thieu-b55/Slimme-meter-ESP32-V2/Slimme meter.jpg

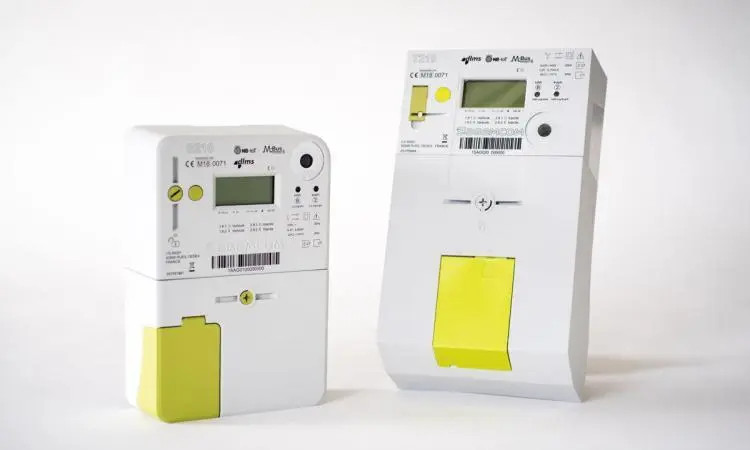
Slimme meter.jpg
