thieu-b55/Slimme-meter-ESP32-V2/Slimme meter ESP32 csv.pdf

# Slimme meter ESP32 V2 interface / sturing

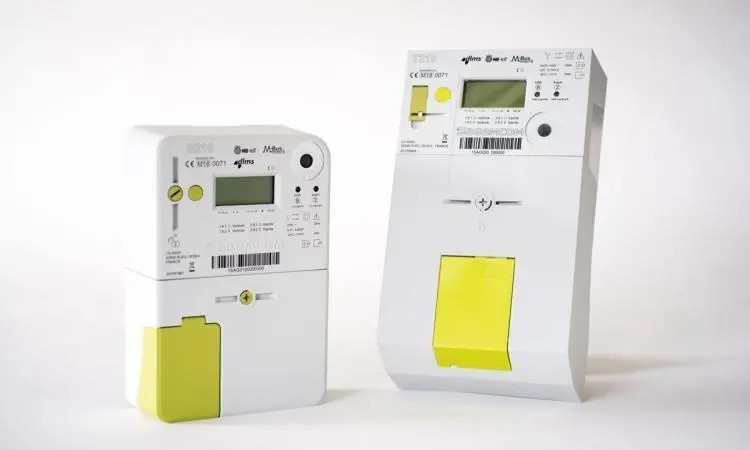
[picture p2: figure]

github pagina voor dit project

https://github.com/thieu-b55/Slimme-meter-ESP32-V2

## Wat kunnen we ermee ?

Inlezen van de P1 poort .
Voor activeren P1 poort zie volgend bladzijde.

## Verbruiksdata in csv formaat

tonen op webpagina of eventueel op display
dagelijks op einde van de dag beschikbaar via seriële poort verzamelen en bewaren op SD kaart.
uurbasis
dagbasis
maandbasis
jaarbasis
maandpiek op maandbasis
data opvraagbaar op :
dagbasis
maandbasis
jaarbasis
laatste 25 jaar (nog wel effe geduld hebben) meer hierover zie vanaf pagina 35
Extra display om verbruiksdata te tonen.

## Maximaal gebruik maken van de eigen opgewekte energie (terugleveren is momenteel toch

redelijk onrendabel)

## 2x PWM uitgang

## 2x Digitale uitgang

## PWM1 uitgang

Kan gebruikt worden voor het sturen van een elektrische boiler, elektrische bijverwarming of eventueel een zwembadverwarming.
Zorgt er door de PWM regeling voor dat er niet meer vermogen naar het verwarmingselement gaat dan dat er door de zonnepanelen geleverd wordt.

## PWM2 uitgang

Doet hetzelfde als PWM1 maar deze regeling wordt pas actief wordt bij een 100% uitsturing van PWM1

## Digitale uitgangen Relais1 en Relais2

Deze kunnen geschakeld worden op tijdsbasis, wanneer er een bepaald vermogen wordt opgewekt of een combinatie van de 2.

## Enkele nuttige adressen:

Meer info over de slimme meter vind je hier https://jensd.be/1205/linux/data-lezen-van-de-belgische-digitale-meter-met-de-p1-poort

handleidingen Nederlandse Slimme meters https://www.netbeheernederland.nl/slimme-meter/slimme-meter-veelgestelde-vragen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* MTczMDU0NTg3Mi4xLjEuMTczMDU0NTg5Mi4wLjAuMA.. (https://www.netbeheernederland.nl/slimme-meter/slimme-meter-veelgestelde-vragen)
bijna op het einde van de pagina.

https://www.fluvius.be/nl/meters-en-meterstanden/digitale-meter/hoe-werkt-mijn-digitale-meter/handleidingen-digitale-elektriciteitsmeters (https://www.fluvius.be/nl/meters-en-meterstanden/digitale-meter/hoe-werkt-mijn-digitale-meter/handleidingen-digitale-elektriciteitsmeters)

Meer info over de OBIS code
https://onemeter.com/docs/device/obis/

De ESP32 wordt geprogrammeerd met de Arduino IDE hoe je deze en de benodigde ESP32 software op je PC moet installeren vind je hier https://randomnerdtutorials.com/installing-the-esp32-board-in-arduino-ide-windows-instructions/

Meer info over ESP32 en nog veel meer
https://randomnerdtutorials.com/projects-esp32/

De P1 poort gratis activeren doe je via Fluvius https://www.fluvius.be/nl/thema/meters-en-meterstanden/digitale-meter/maak-je-meter-slim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 (https://www.fluvius.be/nl/thema/meters-en-meterstanden/digitale-meter/maak-je-meter-slim)

Er zijn meerdere types “slimme meter” in omloop. De aansluitingen en software van dit project zijn gebaseerd op het type meter hierboven afgebeeld. Meer info over de andere meters vind je op de link hieronder.
https://domoticx.com/p1-poort-slimme-meter-hardware/

## ### Compileren met Arduino core for ESP32 versie 3.0.5 ###

Gebruik de volgende libraries :

https://github.com/me-no-dev/AsyncTCP

https://github.com/me-no-dev/ESPAsyncWebServer

Op de github pagina:

https://github.com/thieu-b55/Slimme-meter-ESP32-V2

in de bin folder is er van elk programma een .bin file aanwezig, indien een niet compatibele update het compileren van een programma verhindert kan deze .bin file in de ESP32 geladen worden. Meer info zie tekst file in .bin folder.

## Dit project is opgebouwd uit 4 modules

## Interface module

Deze leest de data uit de P1 poort van de slimme meter in en maakt deze beschikbaar voor verdere verwerking.
De ESP32 is ingesteld in de Access Point Mode en heeft zijn eigen netwerk namelijk:
Netwerk: | ESP32Energie_csv
Paswoord: | ESP32pswd
IPaddress: | 192.168.4.1

## Display Module

Weergave van :

Totaal elektriciteitsverbruik

Totaal injectie

Totaal gasverbruik

Huidig verbruik (rood) of injectie (groen)

Status van de 2 digitale en de 2 PWM uitgangen

## PWM Module

Voor het sturen van bijvoorbeeld een elektrische boiler of elektrische verwarmingstoestel in functie van het zelf opgewekt vermogen.

## Output Module

Voor het sturen van een uitgang op een gewenst ogenblik, als er een gewenst vermogen wordt opgewekt of een combinatie van de 2.

## Interface Module

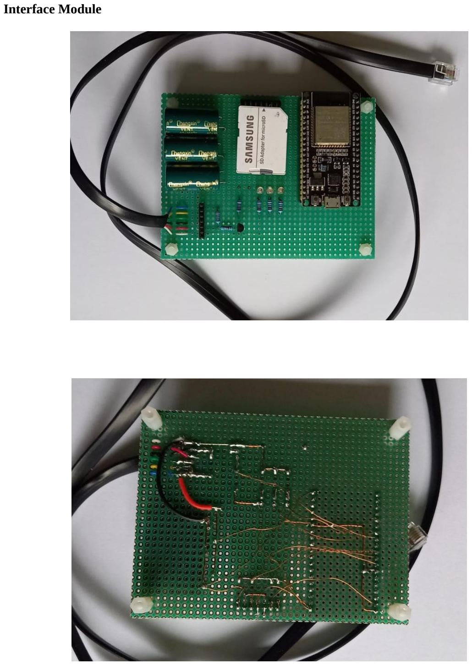
[picture p3: page 6]

Leest de gegevens van de P1 poort en stuurt deze naar een webpagina SD kaart.

Mogelijkheid voor het sturen van 2 digitale en 2 PWM uitgangen in functie van het opgewekt vermogen
op tijdsbasis.

Stuurt gegevens eventueel door naar apart LCD scherm.

Bewaart data op SD kaart dit voor zowel elektriciteitsverbruik, elektriciteitsinjectie, maandpiek en indien aanwezig aardgas.
Dit per uur , dag , maand , jaar. Maandpiek alleen per maand.

Een volledig jaar beslaat +/- 140 KB op een SD kaart. 16GB volstaat voor enkele honderden jaren.

Alvorens de P1 poort op de meter te kunnen gebruiken, moet deze eerst geactiveerd worden. Voor België moet dit gebeuren via Fluvius.

https://www.fluvius.be/nl/meters-en-meterstanden/digitale-meter/maak-je-meter-slim?app-refresh=1730576514541 (https://www.fluvius.be/nl/meters-en-meterstanden/digitale-meter/maak-je-meter-slim?app-refresh=1730576514541)

## Onderdelen

1 x kabeltje met RJ12 plug 1x ESP32WROOM Devkit
1x SD card module

of
1x SD card houder

indien deze optie
4x 10K extra

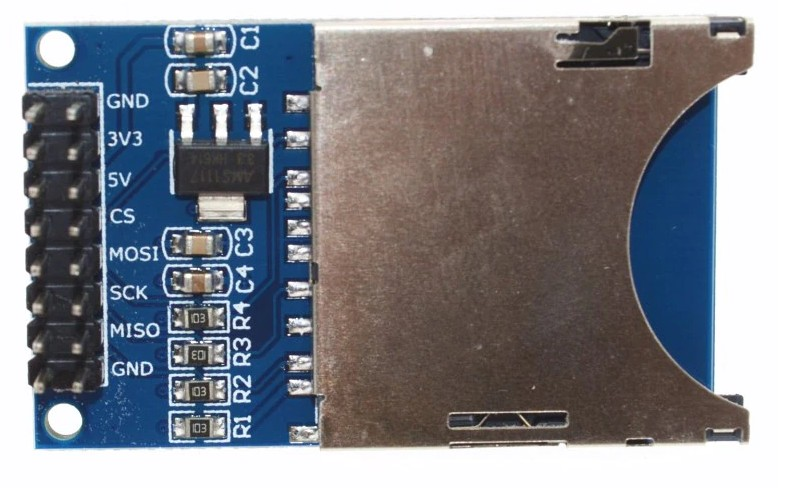
[picture p4: figure]
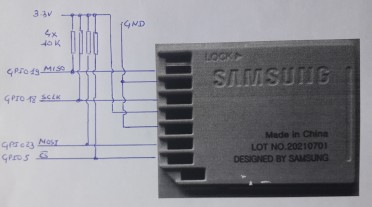
[picture p5: figure]

1 x SD kaart FAT32 geformatteerd. 1x BC547
3x LED
1x R 1K
1x R 10K
1x R 2K2
3 x R20K
3x 4700 uF / 16 Volt
(eventueel een aparte 5 Volt voeding zie beschrijving)

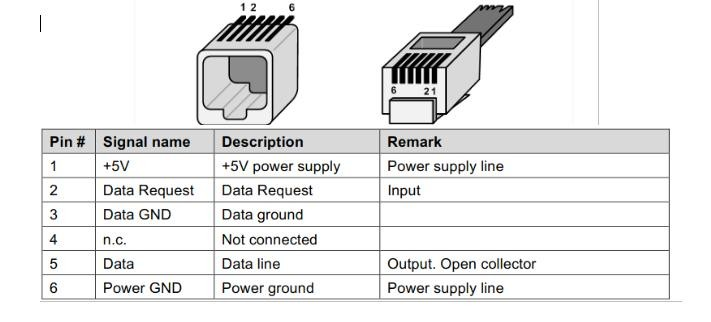
[picture p6: figure]
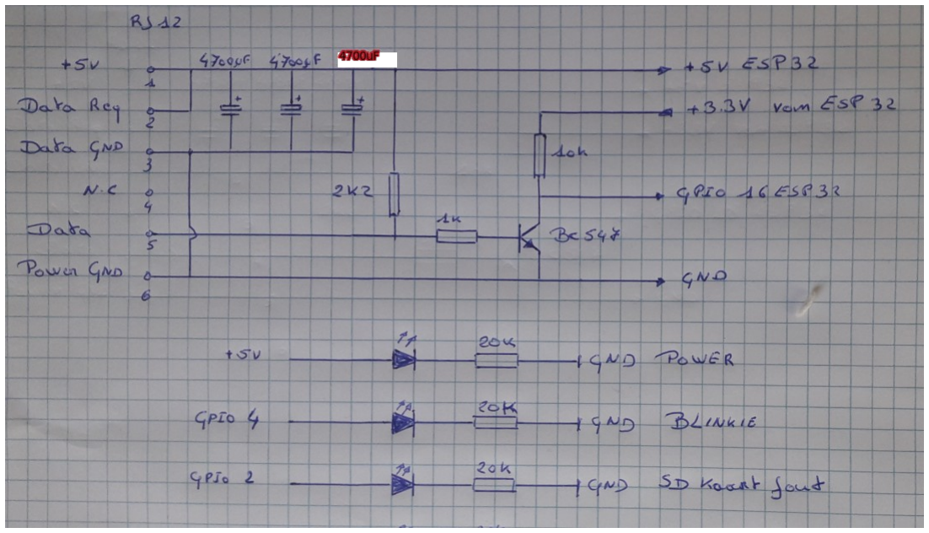
[picture p7: figure]

Volgens de beschrijving kan deze P1 poort 5 Volt 250 mA leveren. Dit is niet genoeg voor de ESP32 module om data te kunnen doorsturen. 3 capaciteiten kunnen dit probleem verhelpen. Enige nadeel is dat na het inpluggen of een eventuele (zeldzame) spanningsuitval de ESP32 module manueel moet gereset worden. Een externe 5 Volt voeding gebruiken kan ook , de 3 capaciteiten zijn dan niet nodig. Ontkoppel dan ook de 5V komende van de meter, Pin2 (Data Request) moet dan wel met de 5V van de meter verbonden blijven.

## Verbindingen

## Aansluitingen ESP32

GPIO23 | >> | MOSI SD kaart
GPIO19 | >> | MISO SD kaart
GPIO18 | >> | SCK SD kaart
GPIO5 | >> | CS SD kaart
GPIO16 | << | BC547 collector uitgang, P1 signaal digitale meter
GPIO4 | >> | LED (BLINKIE) verandert status bij elke leescyclus data
| | van P1 poort. Indien OK frequentie 0.5Hz (1 leescyclus per seconde)
GPIO2 | >> | LED SD ERROR. 1 bij SD kaart error
5V | << | van P1 poort of externe voeding
3x GND | << | van P1 poort /externe voeding
3.3V | >> | 3.3V SD kaart
| >> | 10k in collector lijn BC547

## Aansluitingen SD module of SD houder

3.3V | << | 3.3V van ESP32
GND | << | GND
/CS | << | GPIO5 ESP32
SCK | << | GPIO18 ESP32
MOSI | << | GPIO23 ESP32
MISO | >> | GPIO19 ESP32

indien er een SD kaarthouder wordt gebruikt verbindt /CS, SCK, MOSI, MISO via R10K met 3.3V van ESP32
Laad programma Slimme_meter_esp32_csv.ino in de ESP32.

Plug de module in de geactiveerde P1 poort van de Slimme Meter. Indien geen externe voeding druk op resetknop van de ESP32 Devkit. Na een 30-tal seconden begint de BLINKIE Led te pinken.

Maak verbinding met:
Netwerk | ESP32Energie_csv
Paswoord | ESP32pswd
IP adres | 192.168.4.1

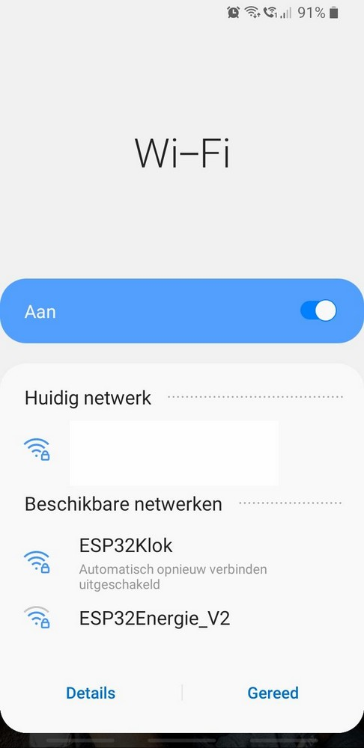
[picture p8: figure]
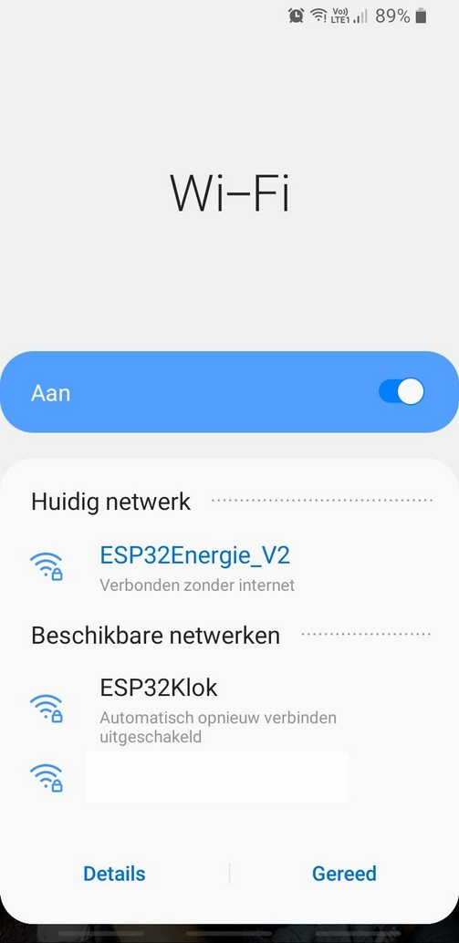
[picture p9: figure]

## Hoofdpagina

Ga naar pagina 192.168.4.1

Dit is de hoofdpagina met:

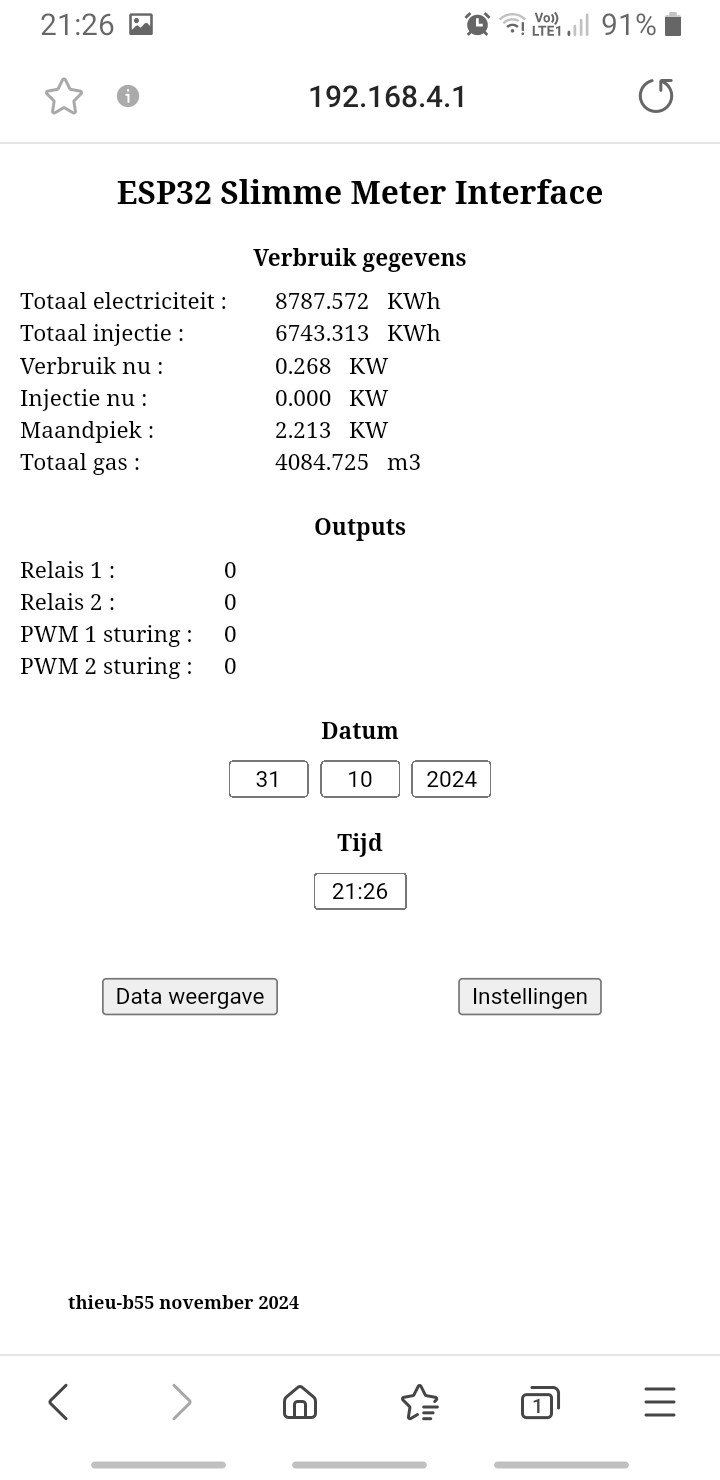
[picture p10: figure]

Totaal elektriciteitsverbruik Totaal injectie
Verbruik nu
Injectie nu
Maandpiek
Totaal gas

Tevens zien we onder Outputs de status van de digitale en PWM outputs, hierover verder meer.

Datum en Tijd komen van de Slimme Meter

Met behulp van de 2 drukknoppen kunnen we kiezen voor <Data weergave>
<Instellingen>

## Instellingen

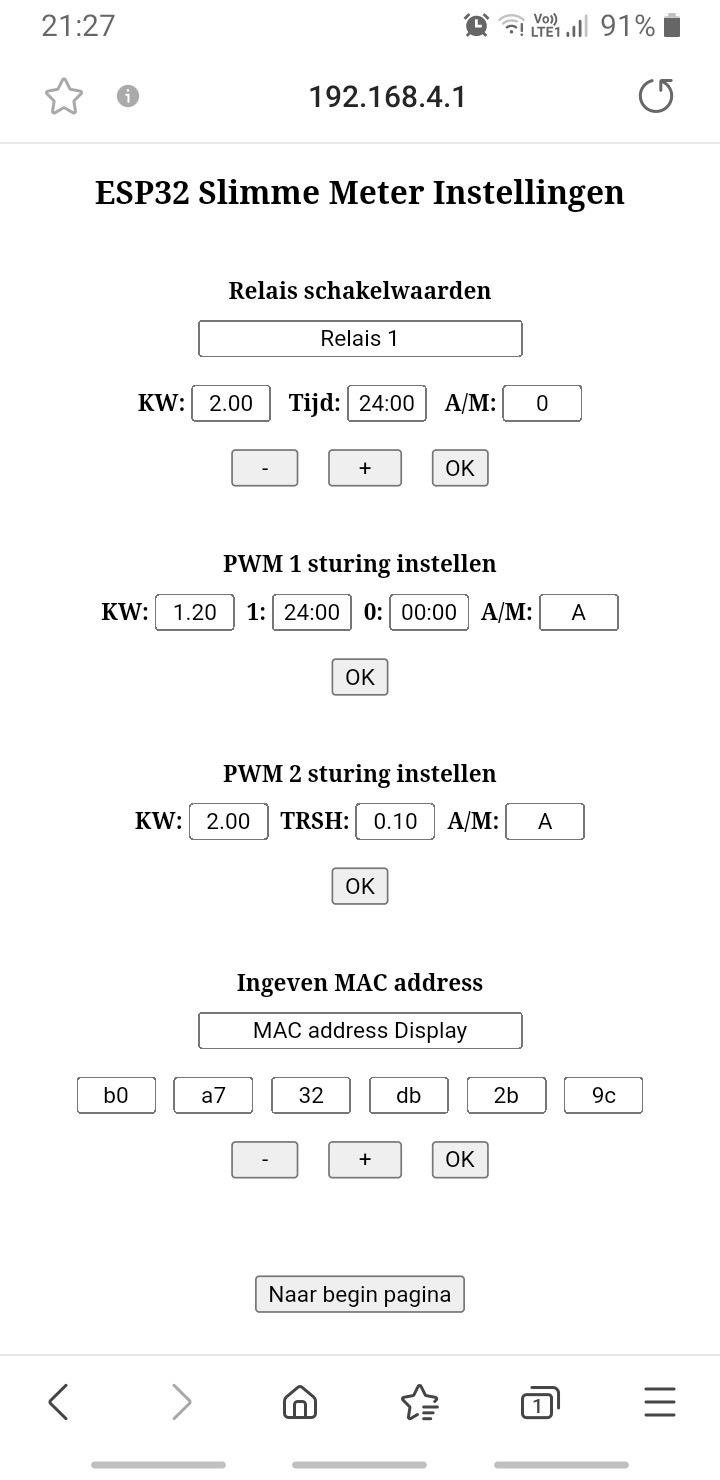
[picture p11: figure]

## Relais schakelwaarden

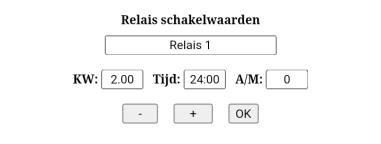
[picture p12: figure]

met behulp van de <-> <+> en <OK> knop kunnen we kiezen tussen Relais 1 en Relais 2

## Werking :

KW | vul hier de waarde in die er opgewekt moet worden alvorens de uitgang "1" kan
worden
Tijd | vul hier het uur in dat de uitgang "1" kan worden
A/M | 0 uitgang "0"
1 uitgang "1"
A uitgang wordt gestuurd door settings

voorbeeld
KW | 1
Tijd | 12:00
A/M | A

Uitgang wordt 1 als:
het 12:00 uur is of later
en
het opgewekt vermogen gelijk wordt aan of groter wordt dan de ingestelde 1KW

een uitgang die eenmaal uitgestuurd is, blijft gestuurd. Dus ook als het opgewekt vermogen daalt onder de ingestelde KW in ons voorbeeld 1 KW.
Uitgangen worden gereset om 00:00 uur.
Om alleen de tijdfunctie te gebruiken | >> zet KW op 0 en Tijd op de gewenste tijd.
Om alleen de KW functie te gebruiken | >> zet Tijd op 00:01 en KW op het gewenste opgewekte
vermogen.

Na het invullen van de gewenste waarden druk op <OK> om te accepteren.

## PWM1 sturing instellen

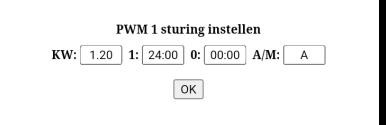
[picture p13: figure]

KW vul hier zo correct mogelijk het vermogen in van de aangesloten verbruiker, dit om een zo stabiel mogelijke regeling te krijgen

### 1 tijd waarop het PWM signaal 100% wordt uitgestuurd 0 stuurt het PWM signaal terug naar 0%

Dit kan gebruikt worden om bij gebruik als aansturing voor een warmwaterboiler altijd verzekerd te zijn van warm water.
Gedurende de dag wordt de boiler opgewarmd met het opgewekte vermogen van de zonnepanelen om dan bijvoorbeeld vanaf 20:00 to 23:30 de warmwaterboiler via de tijdsschakeling bij te warmen. Op die manier heeft men altijd warm water ook op een minder zonnige dag.

A/M 0: PWM1 wordt 0% uitgestuurd
| 1: PWM1 signaal wordt 100% uitgestuurd A: percentage uitsturing PWM signaal is afhankelijk van het opgewekte vermogen en het vermogen van de belasting die is ingesteld in KW

De regeling tracht het vermogen naar de belasting zo te regelen dat dit overeenkomt met het beschikbaar geïnjecteerd vermogen.

## PWM2 sturing instellen

KW vul hier zo correct mogelijk het vermogen in van de aangesloten verbruiker, dit om een zo stabiel mogelijke regeling te krijgen

TRSH vul hier een waarde in in KW. Indien PWM1 100% is uitgestuurd en er is nog zelf
| opgewekt vermogen beschikbaar, dan probeert de regeling het vermogen naar de verbruiker zo te regelen dat er nog steeds een vermogen gelijk aan de waarde hier ingevuld beschikbaar blijft. Dit om de regeling van PWM1 zo weinig mogelijk te verstoren met de regeling van PWM2

A/M 0: PWM2 wordt 0% uitgestuurd
| 1: PWM2 wordt 100% uitgestuurd A: percentage uitsturing PWM2 is afhankelijk van PWM1 = 100% nog beschikbaar opgewekt vermogen > waarde ingevuld in TRSH

Bij PWM1 = 100% en nog beschikbaar opgewekt vermogen > TRSH probeert de regeling het nog beschikbaar opgewekt vermogen zo te regelen dat deze gelijk is aan de waarde ingevuld in TRSH

De combinatie van PWM1 met PWM2 kan gebruikt worden om het maximum aan opgewekte energie zelf te gebruiken.
PWM1 als aansturing voor een warmwaterboiler.
Met PWM2 kan dan het nog resterende gedeelte van de opgewekte energie naar een simpel elektrische bijverwarming gestuurd worden,.
Momenteel bedraagt het bedrag dan men krijgt voor 1KWh geïnjecteerd vermogen 0.04€ (Luminus november 2024) en de prijs voor 1KWh gas +/- 0.09€ (Engie 2024).
Elke KWh gas die men kan vervangen door een KWh opgewekte elektriciteit levert dus 0.05€ op. Rijk zal men er niet van worden, maar het blijft een hobby natuurlijk.
Voor in de zomermaanden is dit geen oplossing maar eventueel kan er de verwarming van een zwembad of jacuzzi op aangesloten worden.
Goede ideeën altijd welkom.

## Ingeven MAC address

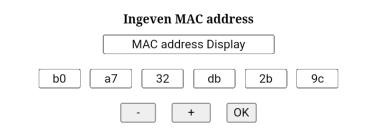
[picture p14: figure]

Om te kunnen functioneren moet voor elke aparte module het juiste MAC address ingevuld zijn. Om het MAC Address te kennen kijk na het uploaden van een programma naar een ESP32 Devkit naar de Arduino IDE, het MAC Address van de module vind je onder in het terminal gedeelte van de IDE

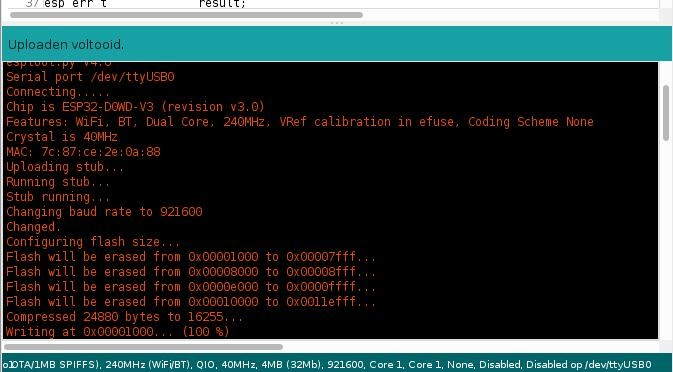
[picture p15: figure]

het MAC Address van deze module is 7c:87:ce:2e:0a:88

kies met behulp van de < + > < - > en < OK > knop van welke module je het MAC address wil invullen.
2 modules hetzelfde MAC Address geven resulteert in een continue reset van de ESP32 Devkit. Na het invullen en accepteren door middel van de < OK > knop van een (1) MAC Address herstart de ESP32 Devkit automatisch.

Eventueel kunnen de MAC adressen ook al ingevuld worden in het programma. Dit in de Setup()

/*
* Display
*/
pref.putInt("mac1_0", 0xb0); pref.putInt("mac1_1", 0xa7); pref.putInt("mac1_2", 0x32); pref.putInt("mac1_3", 0xdb); pref.putInt("mac1_4", 0x2b); pref.putInt("mac1_5", 0x9c); /*
* Relais 1
*/
pref.putInt("mac2_0", 7);
pref.putInt("mac2_1", 1);
pref.putInt("mac2_2", 2);
pref.putInt("mac2_3", 3);
pref.putInt("mac2_4", 4);
pref.putInt("mac2_5", 7);
/*
* Relais 2
*/
pref.putInt("mac3_0", 2);
pref.putInt("mac3_1", 1);
pref.putInt("mac3_2", 2);
pref.putInt("mac3_3", 3);
pref.putInt("mac3_4", 4);
pref.putInt("mac3_5", 5);
/*
* PWM 1
*/
pref.putInt("mac4_0", 0x7c); pref.putInt("mac4_1", 0x9e); pref.putInt("mac4_2", 0xbd); pref.putInt("mac4_3", 0x06); pref.putInt("mac4_4", 0xb4); pref.putInt("mac4_5", 0xdc); /*
* PWM 2
*/
pref.putInt("mac5_0", 0x7c); pref.putInt("mac5_1", 0x87); pref.putInt("mac5_2", 0xce); pref.putInt("mac5_3", 0x30); pref.putInt("mac5_4", 0x7e); pref.putInt("mac5_5", 0x24);

## Naar begin

druk op <Naar begin pagina> om naar de begin pagina te gaan.

## Data weergave

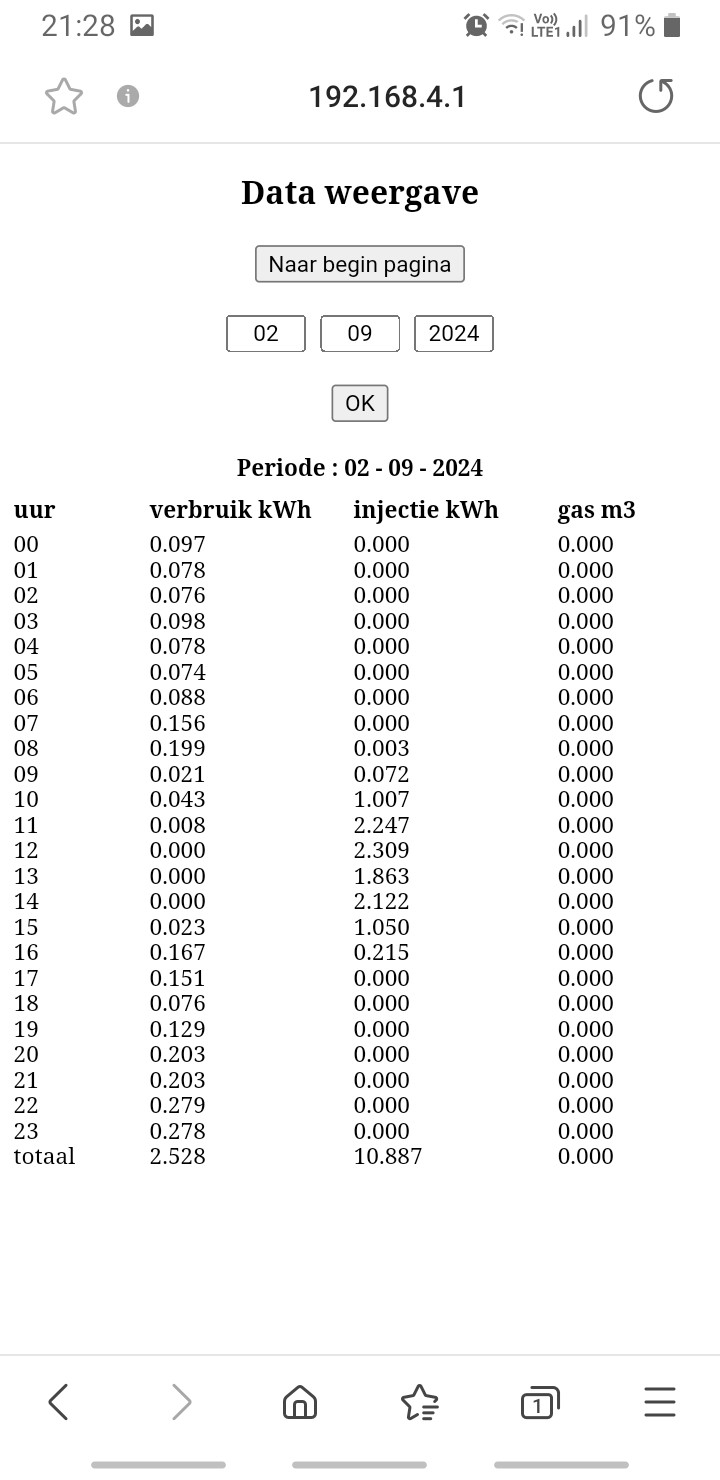
[picture p16: figure]

Vul dag - maand – jaar in om het uurverbruik van die bepaalde dag op te vragen

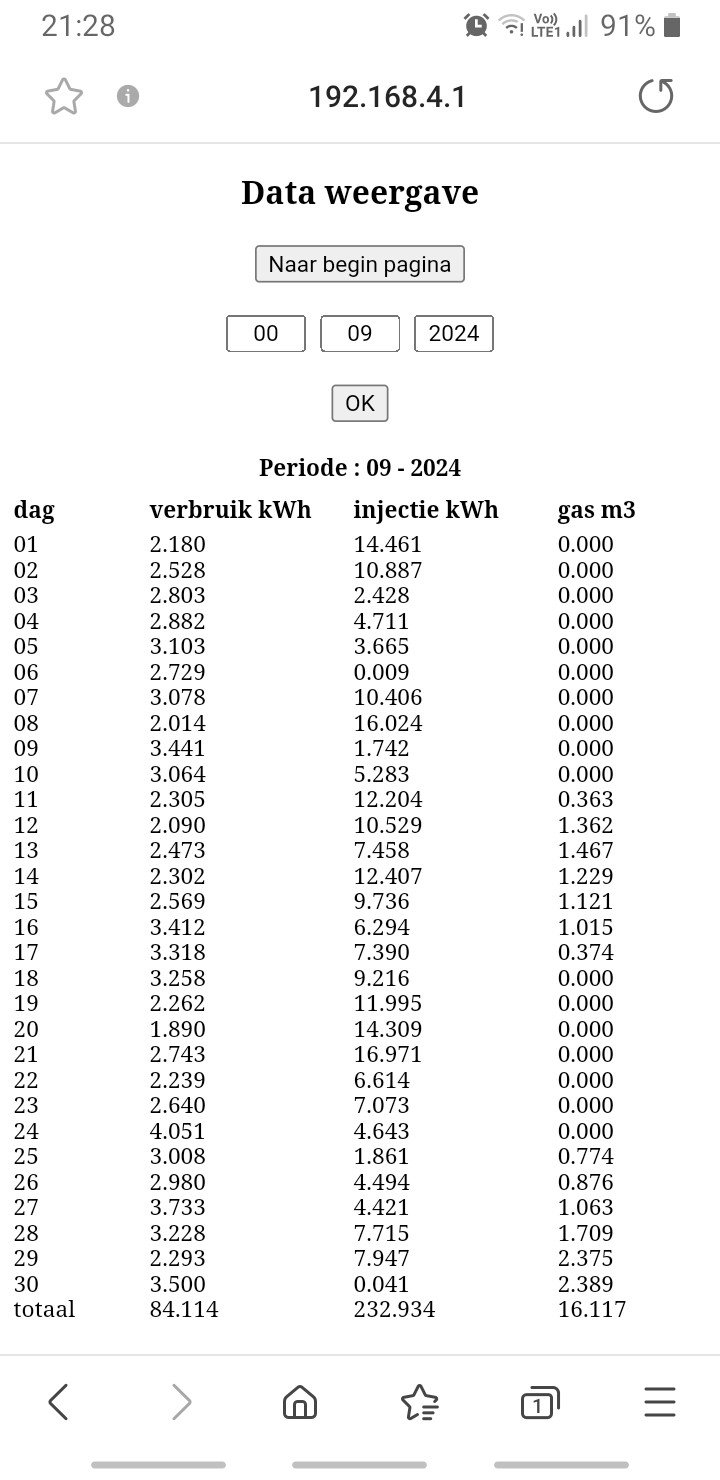
[picture p17: figure]

vul 0 – maand – jaar in om het dag verbruik van die bepaalde maand op te vragen

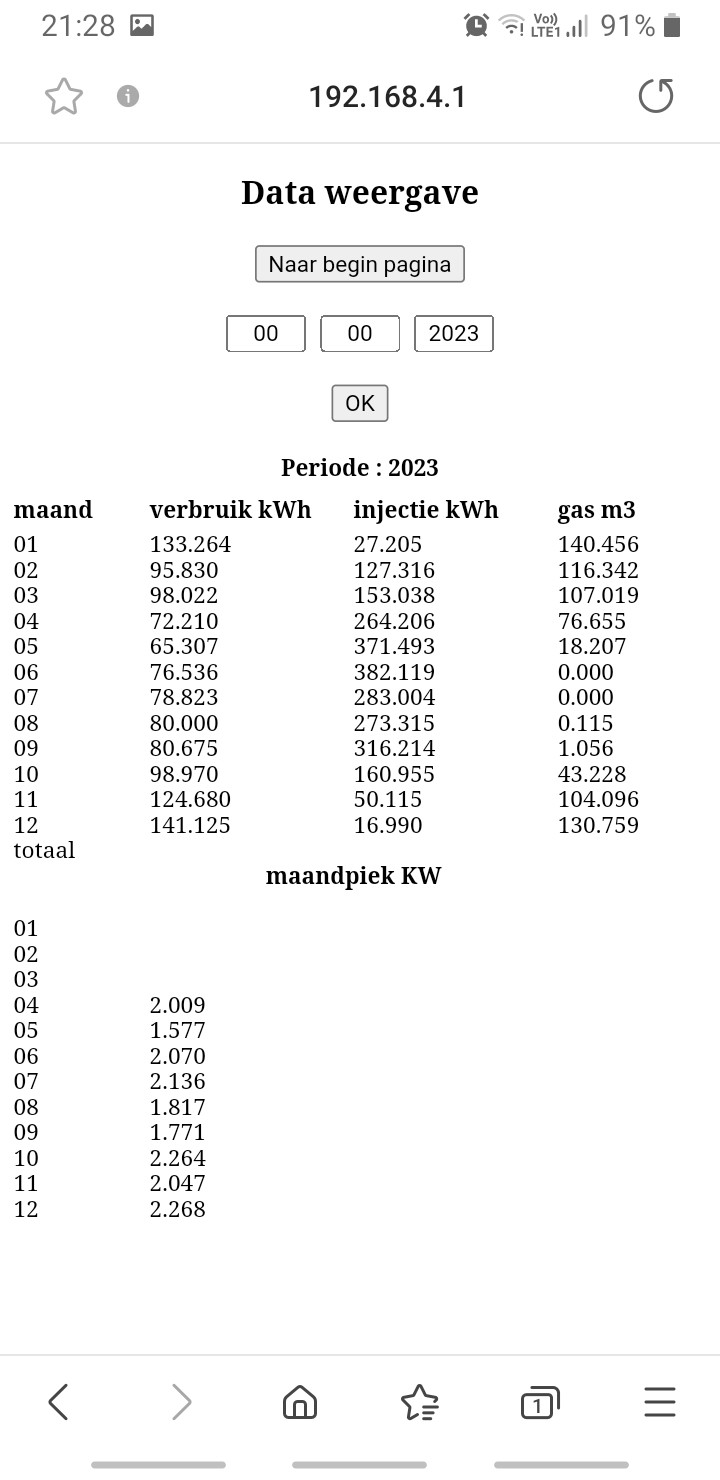
[picture p18: figure]

vul 0 - 0 - jaar in om het maandverbruik van dat bepaald jaar op te vragen. Ook de maandelijkse maandpiek wordt nu getoond

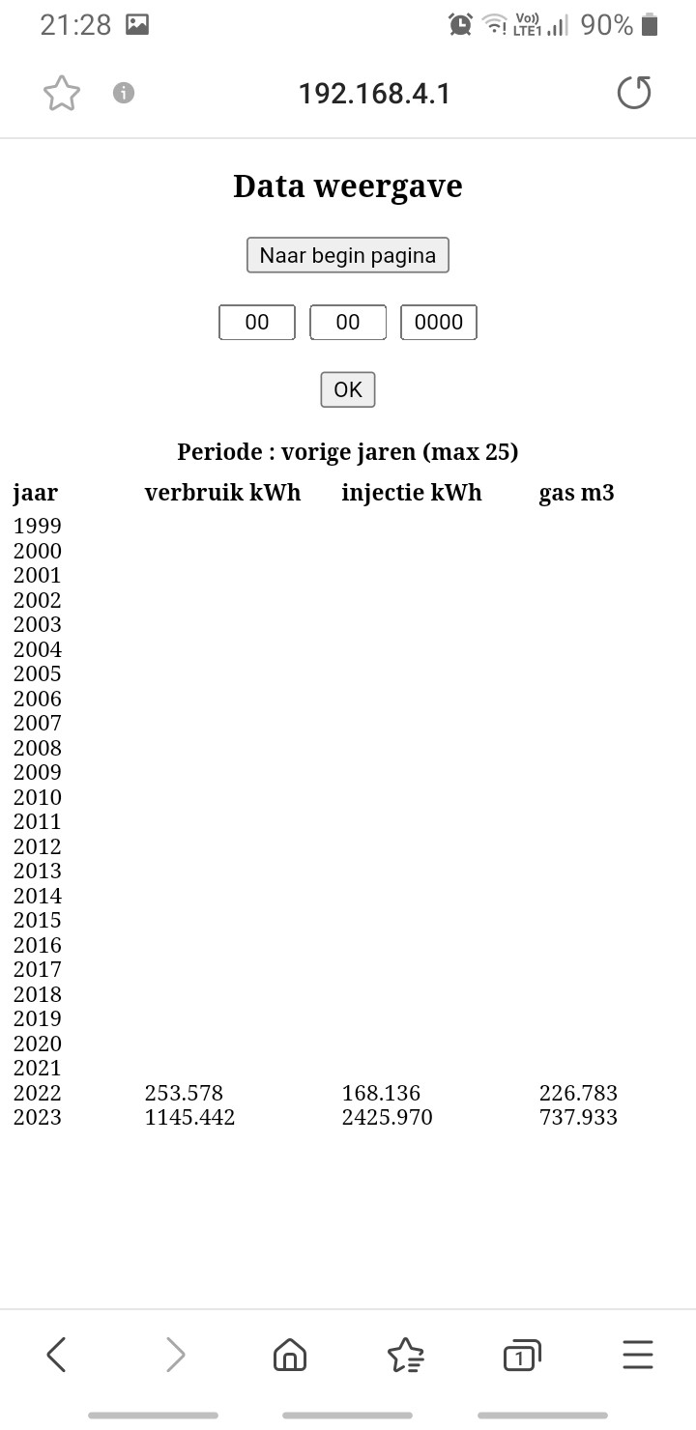
[picture p19: figure]

Vul 0 - 0 – 0 om het jaarverbruik van de laatste 25 jaren op te vragen. Alvorens dit geheel ingevuld is, is een portie geduld zeker zo handig.

## Display module

## Onderdelen

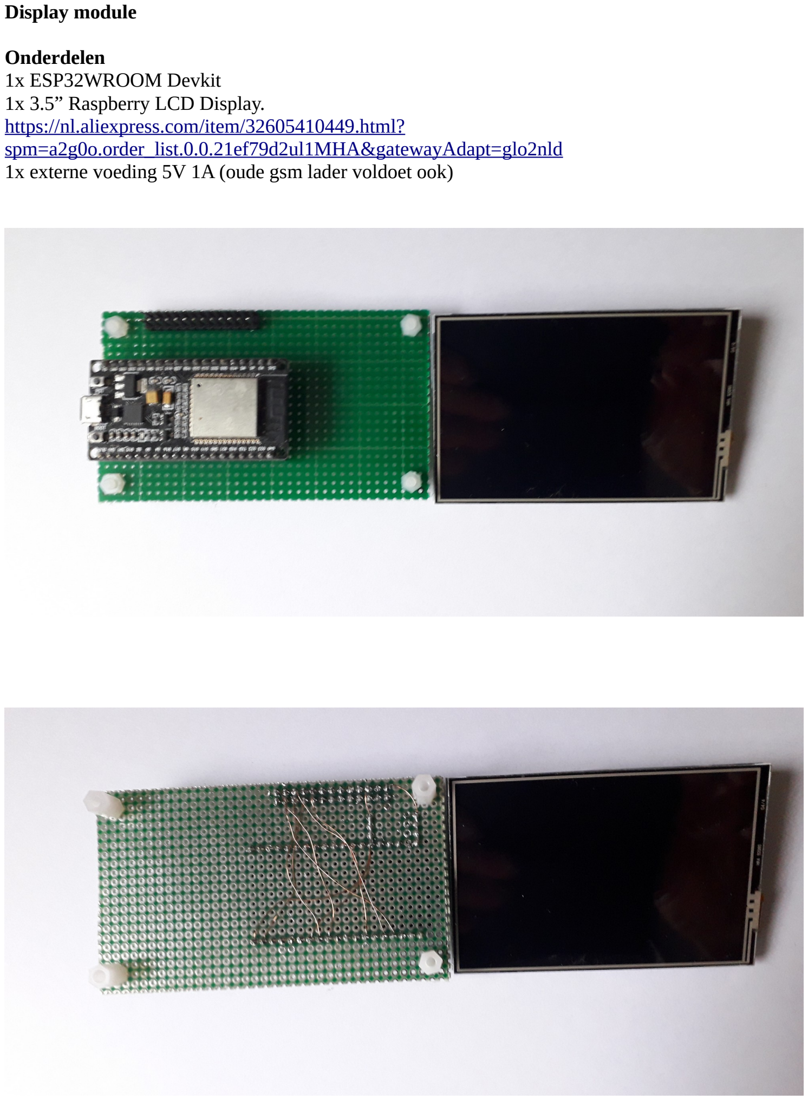
[picture p20: page 24]

1x ESP32WROOM Devkit
1x 3.5” Raspberry LCD Display. https://nl.aliexpress.com/item/32605410449.html?spm=a2g0o.order_list.0.0.21ef79d2ul1MHA&gatewayAdapt=glo2nld (https://nl.aliexpress.com/item/32605410449.html) 1x externe voeding 5V 1A (oude gsm lader voldoet ook)

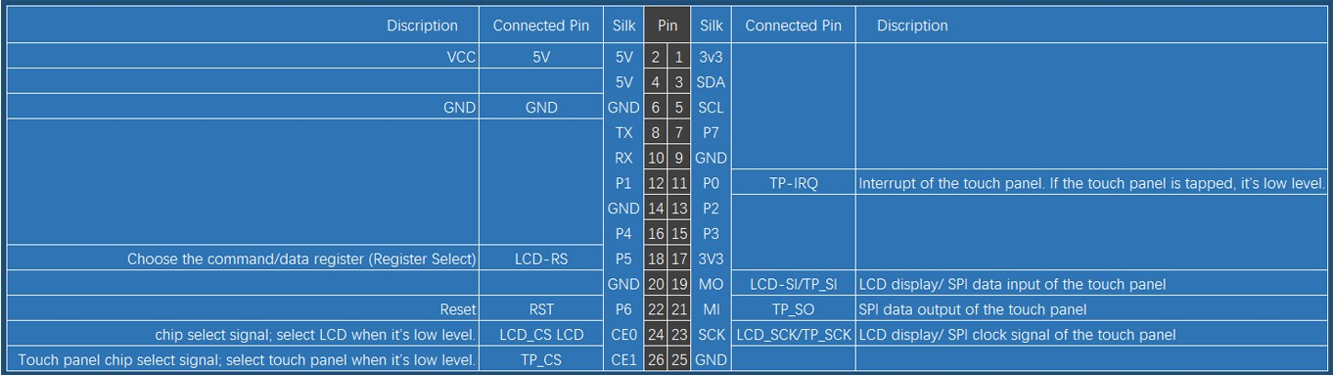
[picture p21: figure]

Bovenstaande afbeelding gevonden op internet, met dank aan de maker.

Hoe aansluiten

LCD display
Pin 2 | 5V | 5V van externe voeding
Pin 6 | GND | GND van externe voeding
Pin18 | C/D | GPIO2
Pin19 | MOSI | GPIO23
Pin21 | MISO | GPIO19
Pin22 | RESET | GPIO4
Pin23 | SCK | GPIO18
Pin24 | CE0 | GPIO15

Overige ESP32 ESP32WROOM Devkit aansluitingen
ESP32 5V | | naar externe 5V
ESP32 GND | | naar externe GND (alle GND’s aansluiten)

In de library TFT_eSPI pas het bestand

## User_Setup_Select.h

aan zoals hieronder.
Er mag maar 1 #include gekozen zijn.

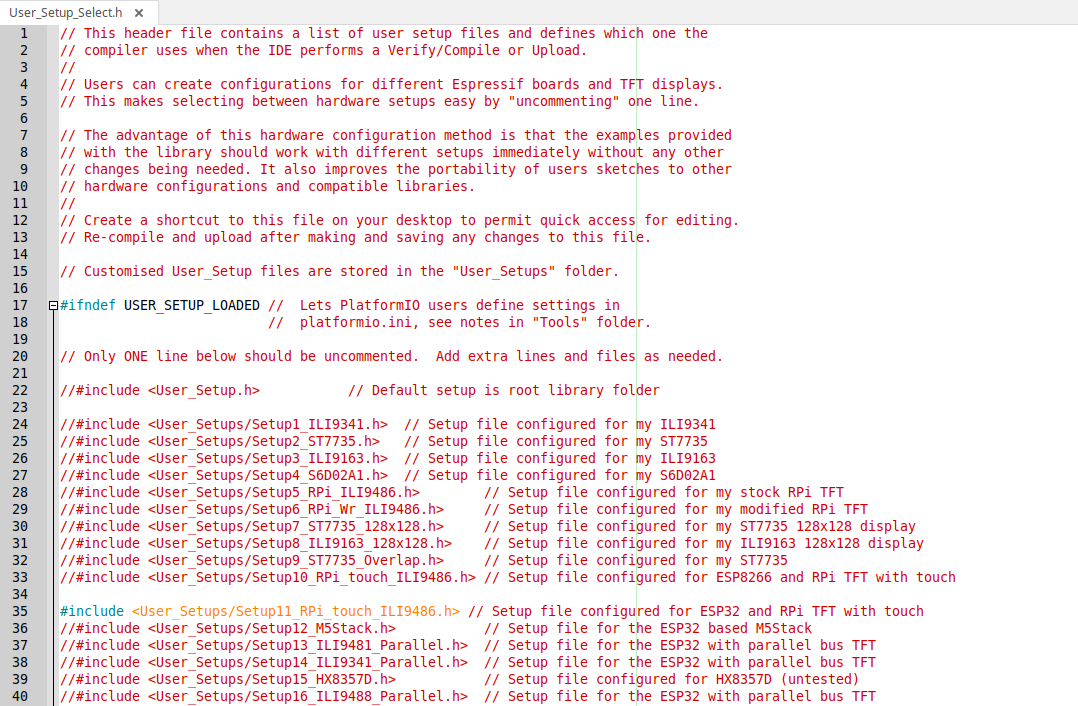
[picture p22: figure]

Laad het programma slimme_meter_esp32_display_V2.ino met behulp van de Arduino IDE in de ESP32WROOM Devkit module.

## Noteer het MAC address zie uitleg bij hoofdstuk <Ingeven MAC address> bij de beschrijving van de interface module hierboven en vul dit in in het programma of vul dit in zoals beschreven bij <Ingeven MAC address>

De interface stuurt elke 10 seconden data naar de display. Na max 10 seconden zou je dit moeten krijgen.

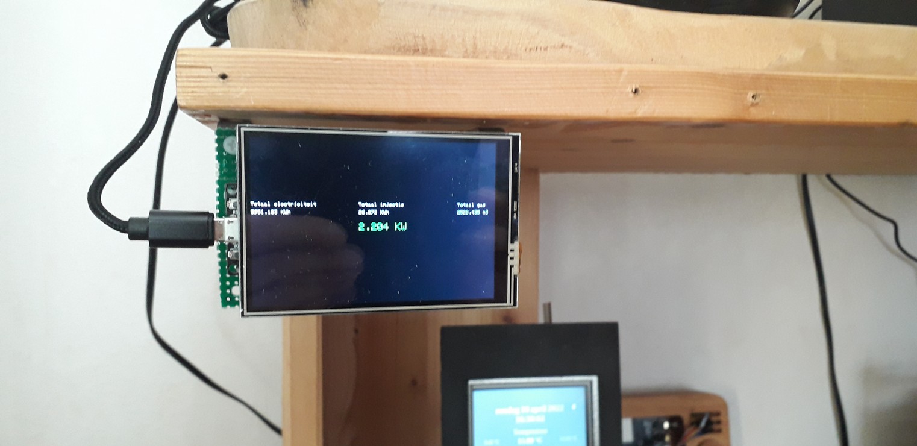
[picture p23: figure]

Display bij injectie, het momenteel geïnjecteerd vermogen in het groen.

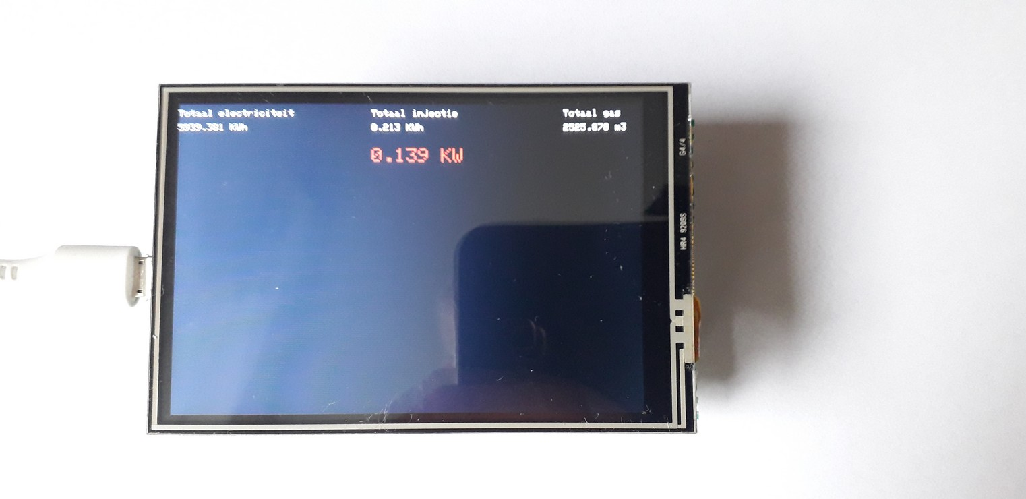
[picture p24: figure]

Display bij afname van het net vermogen in het rood.

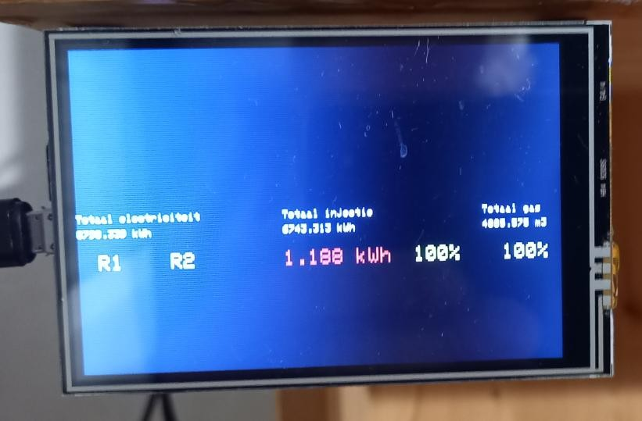
[picture p25: figure]

De display toont of er een relais uitgestuurd is en het percentage uitsturing van de beide PWM signalen indien groter dan 0.

## Digitale uitgangsmodule

## Onderdelen

1x ESP32WROOM Devkit
1x externe voeding 5V
1x hoog vermogen 5V relais https://nl.aliexpress.com/item/4000185959463.html

## Kies de 5V uitvoering

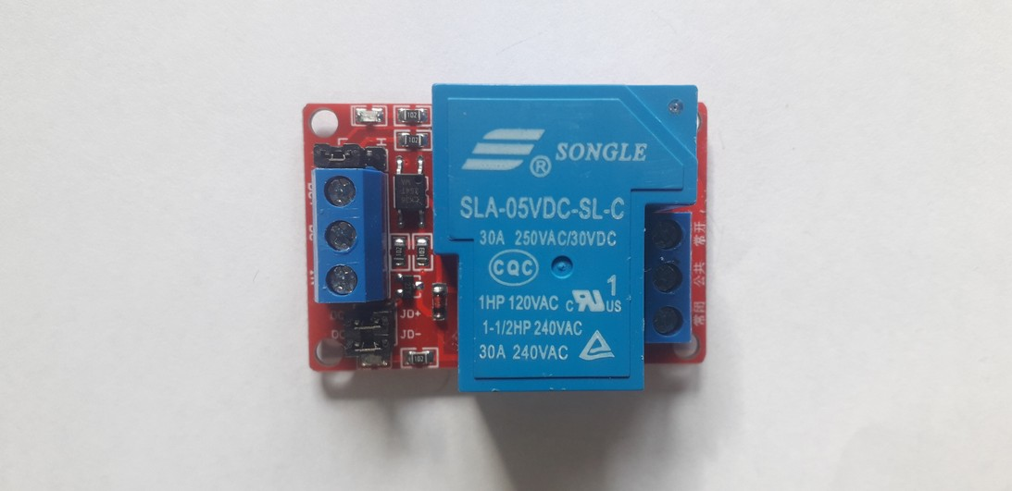
[picture p26: figure]

Relais zou volgens beschrijving 30A kunnen schakelen. Niet geprobeerd, maar aangezien een huishoudtoestel bij opstart slechts een laag vermogen verbruikt, is dat niet ook niet nodig. Getest op wasmachine en relais doet wat hij moet doen.

Hoe aansluiten
ESP32
ESP32 5V | naar externe 5V
ESP32 GND | naar externe GND (alle GND’s aansluiten)
ESP32 GPIO16 | zie schema hieronder

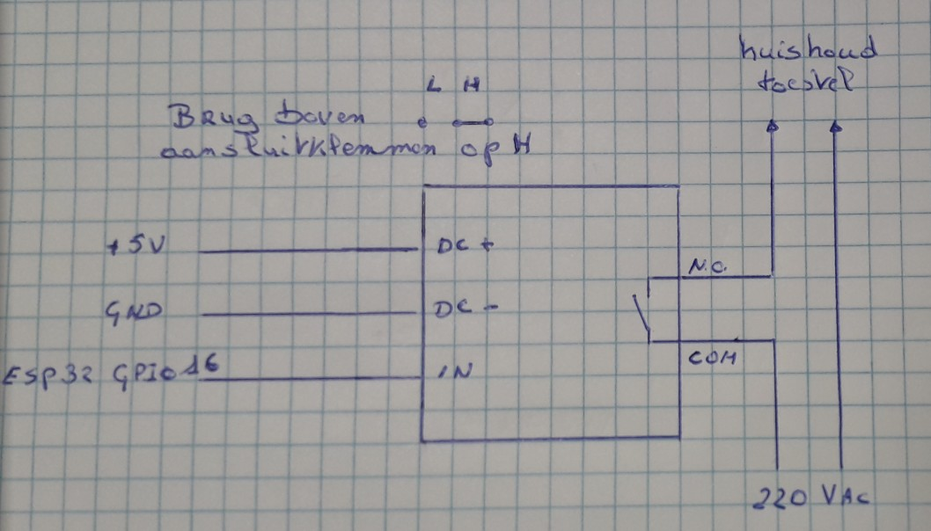
[picture p27: figure]

Laad het programma Slimme_meter_esp32_relais_V2.ino met behulp van de Arduino IDE in de ESP32WROOM Devkit module.

## Noteer het MAC address zie uitleg bij hoofdstuk <Ingeven MAC address> bij de beschrijving van de interface module hierboven en vul dit in in het programma of vul dit in zoals beschreven bij <Ingeven MAC address>

Voor het instellen van de schakelwaarden van de beide digitale uitgangen naar

## <Instellingen>

met behulp van de <-> <+> en <OK> knop kunnen we kiezen tussen Relais 1 en Relais 2

De werking is als volgt

KW | vul hier de waarde in die er opgewekt moet worden alvorens de uitgang "1" kan
worden
Tijd | vul hier het uur in dat de uitgang "1" kan worden
A/M | 0 uitgang "0"
1 uitgang "1"
A uitgang wordt gestuurd door settings

voorbeeld
KW | 1
Tijd | 12:00
A/M | A

Uitgang wordt 1 als:
het 12:00 uur is of later
en
het opgewekt vermogen gelijk wordt aan of groter wordt dan de ingestelde 1KW

een uitgang die eenmaal uitgestuurd is, blijft gestuurd. Dus ook als het opgewekt vermogen daalt onder de ingestelde KW in ons voorbeeld 1 KW.
Uitgangen worden gereset om 00:00 uur.
Om alleen de tijdfunctie te gebruiken | >> zet KW op 0 en Tijd op de gewenste tijd.
Om alleen de KW functie te gebruiken | >> zet Tijd op 00:01 en KW op het gewenste opgewekte
vermogen.

Na het invullen van de gewenste waarden druk op <OK> om te accepteren.

## PWM uitgangsmodule

## Onderdelen

1x ESP32WROOM Devkit
1x 5V voeding
1x solid state relais welke kan gestuurd worden met 3.3V https://nl.aliexpress.com/item/1005003457372056.html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 %21EUR
%2113.15%216.38%21%21%2113.99%216.79%21%40211b617b17307544523485869ef73d %2112000028036460098%21sea%21BE %210%21ABX&curPageLogUid=tNLev7PNmeBK&utparam-url=scene%3Asearch %7Cquery_from%3A (https://nl.aliexpress.com/item/1005003457372056.html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)

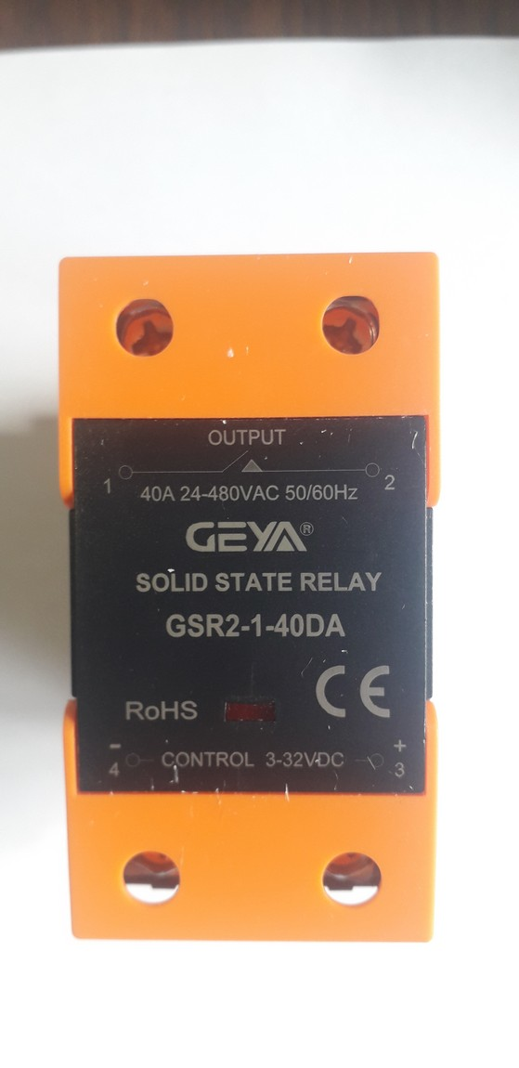
[picture p28: figure]
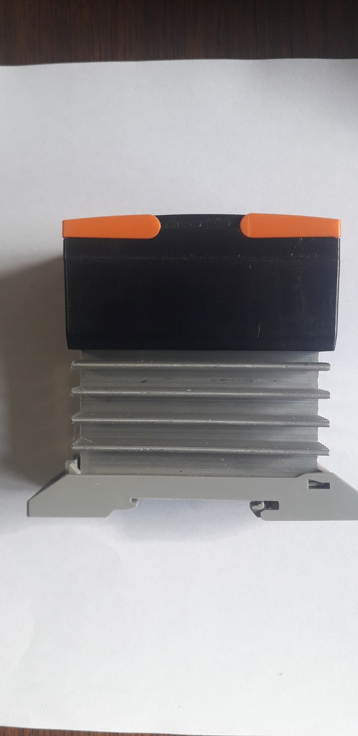
[picture p29: figure]
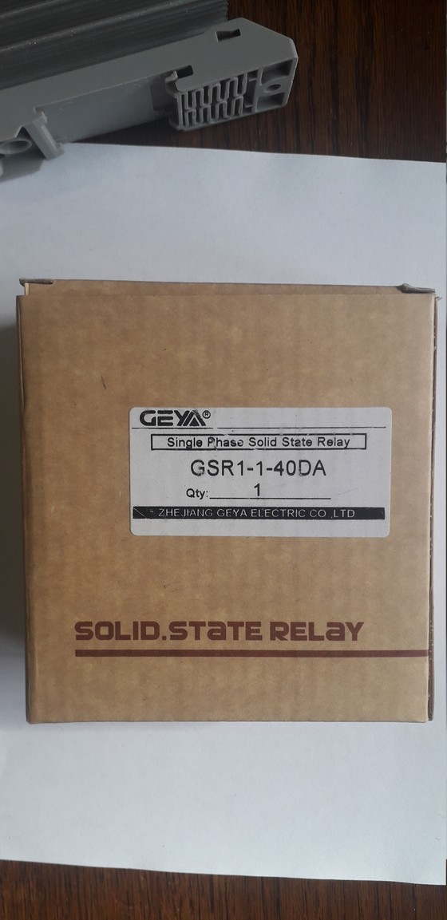
[picture p30: figure]

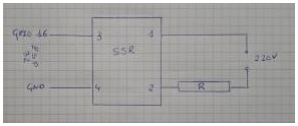
[picture p31: figure]

GPIO16 | >> | SSR module 3
ESP32 GND | >> | SSR module 4
SSR module 1 | >> | 220V N
SSR module 2 | >> | verwarmingsweerstand
220V L | >> verwarmingsweerstand << SSR module 2

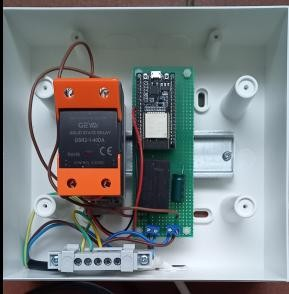
[picture p32: figure]

Laad het programma Slimme_meter_esp32_pwm_V2.ino met behulp van de Arduino IDE in de ESP32WROOM Devkit module.

## Noteer het MAC address zie uitleg bij hoofdstuk <Ingeven MAC address> bij de beschrijving van de interface module hierboven en vul dit in in het programma of vul dit in zoals beschreven bij <Ingeven MAC address>

Om de PWM modules in te stellen ga naar

## <Instellingen>

## PWM1 sturing instellen

KW vul hier zo correct mogelijk het vermogen in van de aangesloten verbruiker, dit om een zo stabiel mogelijke regeling te krijgen

### 1 tijd waarop het PWM signaal 100% wordt uitgestuurd 0 stuurt het PWM signaal terug naar 0%

Dit kan gebruikt worden om bij gebruik als aansturing voor een warmwaterboiler altijd verzekerd te zijn van warm water.
Gedurende de dag wordt de boiler opgewarmd met het opgewekte vermogen van de zonnepanelen om dan bijvoorbeeld vanaf 20:00 to 23:30 de warmwaterboiler via de tijdsschakeling bij te warmen. Op die manier heeft men altijd warm water ook op een minder zonnige dag.

A/M 0: PWM1 wordt 0% uitgestuurd
| 1: PWM1 signaal wordt 100% uitgestuurd A: percentage uitsturing PWM signaal is afhankelijk van het opgewekte vermogen en het vermogen van de belasting die is ingesteld achter KW

De regeling tracht het vermogen naar de belasting zo te regelen dat dit overeenkomt met het beschikbaar geïnjecteerd vermogen.

## PWM2 sturing instellen

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

TRSH vul hier een waarde in in KW. Indien PWM1 100% is uitgestuurd en is nog zelf opgewekt e
| vermogen beschikbaar, dan probeert de regeling het vermogen naar de verbruiker zo te regelen dat er nog steeds een vermogen gelijk aan de waarde hier ingevuld beschikbaar blijft. Dit om de regeling van PWM1 zo weinig mogelijk te verstoren met de regeling van PWM2

A/M 0: PWM2 wordt 0% uitgestuurd
| 1: PWM2 wordt 100% uitgestuurd A: percentage uitsturing PWM2 is afhankelijk van PWM1 = 100% nog beschikbaar opgewekt vermogen > waarde ingevuld in TRSH

Bij PWM1 = 100% en nog beschikbaar opgewekt vermogen > TRSH probeert de regeling het nog beschikbaar opgewekt vermogen zo te regelen dat deze gelijk is aan de waarde ingevuld in TRSH

De combinatie van PWM1 met PWM2 kan gebruikt worden om het maximum aan opgewekte energie zelf te gebruiken.
PWM1 als aansturing voor een warmwaterboiler.
Met PWM2 kan dan het nog resterende gedeelte van de opgewekte energie naar een simpel elektrische bijverwarming gestuurd worden,.
Momenteel bedraagt het bedrag dan men krijgt voor 1KWh geïnjecteerd vermogen 0.04€ (Luminus november 2024) en de prijs voor 1KWh gas +/- 0.09€ (Engie 2024).
Elke KWh gas die men kan vervangen door een KWh opgewekte elektriciteit levert dus 0.05€ op. Rijk zal men er niet van worden, maar het blijft een hobby natuurlijk.
Voor in de zomermaanden is dit geen oplossing maar eventueel kan er de verwarming van een zwembad of jacuzzi op aangesloten worden.
Goede ideeën altijd welkom.

## csv bestand

Data wordt op SD kaart bewaard in csv formaat
Op het einde van elke dag worden de daggevens in csv formaat doorgestuurd via de Seriële poort en weggeschreven naar SD kaart

Opbouw csv bestand via seriële poort of in de maand_x file op SD kaart

## Header

jaar,maand,dag,verbruik_0,injectie_0,gas_0,verbruik_1,injectie_1,gas_1,verbruik_2,injectie_2,gas_ 2,verbruik_3,injectie_3,gas_3,verbruik_4,injectie_4,gas_4,verbruik_5,injectie_5,gas_5,verbruik_6,i njectie_6,gas_6,verbruik_7,injectie_7,gas_7,verbruik_8,injectie_8,gas_8,verbruik_9,injectie_9,gas_ 9,verbruik_10,injectie_10,gas_10,verbruik_11,injectie_11,gas_11,verbruik_12,injectie_12,gas_12,v erbruik_13,injectie_13,gas_13,verbruik_14,injectie_14,gas_14,verbruik_15,injectie_15,gas_15,verb ruik_16,injectie_16,gas_16,verbruik_17,injectie_17,gas_17,verbruik_18,injectie_18,gas_18,verbrui k_19,injectie_19,gas_19,verbruik_20,injectie_20,gas_20,verbruik_21,injectie_21,gas_21,verbruik_ 22,injectie_22,gas_22,verbruik_23,injectie_23,gas_23,verbruik_dag,injectie_dag,gas_dag,verbruik_ maand,injectie_maand,gas_maand,maandpiek,verbruik_jaar,injectie_jaar,gas_jaar
Kolom | data | formaat | extra info
A | jaar | int
B | maand | int
C | dag | int
D | verbruik uur 0 | float 3 decimalen
E | injectie uur 0 | float 3 decimalen
F | gas verbruik uur 0 | float 3 decimalen
G | verbruik uur 1 | float 3 decimalen
H | injectie uur 1 | float 3 decimalen
I | gas verbruik uur 1 | float 3 decimalen
J | verbruik uur 2 | float 3 decimalen
K | injectie uur 2 | float 3 decimalen
L | gas verbruik uur 2 | float 3 decimalen
M | verbruik uur 3 | float 3 decimalen
N | injectie uur 3 | float 3 decimalen
O | gas verbruik uur 3 | float 3 decimalen
P | verbruik uur 4 | float 3 decimalen
Q | injectie uur 4 | float 3 decimalen
R | gas verbruik uur 4 | float 3 decimalen
S | verbruik uur 5 | float 3 decimalen
T | injectie uur 5 | float 3 decimalen
U | gas verbruik uur 5 | float 3 decimalen
V | verbruik uur 6 | float 3 decimalen
W | injectie uur 6 | float 3 decimalen
X | gas verbruik uur 6 | float 3 decimalen
Y | verbruik uur 7 | float 3 decimalen
Z | injectie uur 7 | float 3 decimalen
AA | gas verbruik uur 7 | float 3 decimalen
AB | verbruik uur 8 | float 3 decimalen
AC | injectie uur 8 | float 3 decimalen
AD | gas verbruik uur 8 | float 3 decimalen
AE | verbruik uur 9 | float 3 decimalen
AF | injectie uur 9 | float 3 decimalen

AG | gas verbruik uur 9 | float 3 decimalen
AH | verbruik uur 10 | float 3 decimalen
AI | injectie uur 10 | float 3 decimalen
AJ | gas verbruik uur 10 | float 3 decimalen
AK | verbruik uur 11 | float 3 decimalen
AL | injectie uur 11 | float 3 decimalen
AM | gas verbruik uur 11 | float 3 decimalen
AN | verbruik uur 12 | float 3 decimalen
AO | injectie uur 12 | float 3 decimalen
AP | gas verbruik uur 12 | float 3 decimalen
AQ | verbruik uur 13 | float 3 decimalen
AR | injectie uur 13 | float 3 decimalen
AS | gas verbruik uur 13 | float 3 decimalen
AT | verbruik uur 14 | float 3 decimalen
AU | injectie uur 14 | float 3 decimalen
AV | gas verbruik uur 14 | float 3 decimalen
AW | verbruik uur 15 | float 3 decimalen
AX | injectie uur 15 | float 3 decimalen
AY | gas verbruik uur 15 | float 3 decimalen
AZ | verbruik uur 16 | float 3 decimalen
BA | injectie uur 16 | float 3 decimalen
BB | gas verbruik uur 16 | float 3 decimalen
BC | verbruik uur 17 | float 3 decimalen
BD | injectie uur 17 | float 3 decimalen
BE | gas verbruik uur 17 | float 3 decimalen
BF | verbruik uur 18 | float 3 decimalen
BG | injectie uur 18 | float 3 decimalen
BH | gas verbruik uur 18 | float 3 decimalen
BI | verbruik uur 19 | float 3 decimalen
BJ | injectie uur 19 | float 3 decimalen
BK | gas verbruik uur 19 | float 3 decimalen
BL | verbruik uur 20 | float 3 decimalen
BM | injectie uur 20 | float 3 decimalen
BN | gas verbruik uur 20 | float 3 decimalen
BO | verbruik uur 21 | float 3 decimalen
BP | injectie uur 21 | float 3 decimalen
BQ | gas verbruik uur 21 | float 3 decimalen
BR | verbruik uur 22 | float 3 decimalen
BS | injectie uur 22 | float 3 decimalen
BT | gas verbruik uur 22 | float 3 decimalen
BU | verbruik uur 23 | float 3 decimalen
BV | injectie uur 23 | float 3 decimalen
BW | gas verbruik uur 23 | float 3 decimalen
BX | dag verbruik | float 3 decimalen
BY | dag injectie | float 3 decimalen
BZ | dag gas verbruik | float 3 decimalen
CA | maand verbruik | float 3 decimalen | laatste dag maand anders 0.000
CB | maand injectie | float 3 decimalen | laatste dag maand anders 0.000
CC | maand gas verbruik | float 3 decimalen | laatste dag maand anders 0.000
CD | maand piek | float 3 decimalen | laatste dag maand anders 0.000
CE | jaar verbruik | float 3 decimalen | laatste dag jaar anders 0.000
CF | jaar injectie | float 3 decimalen | laatste dag jaar anders 0.000

CG | jaar gas verbruik | float 3 decimalen | laatste dag jaar anders 0.000
Importeren in LibreOffice Calc
gebruik volgende instellingen

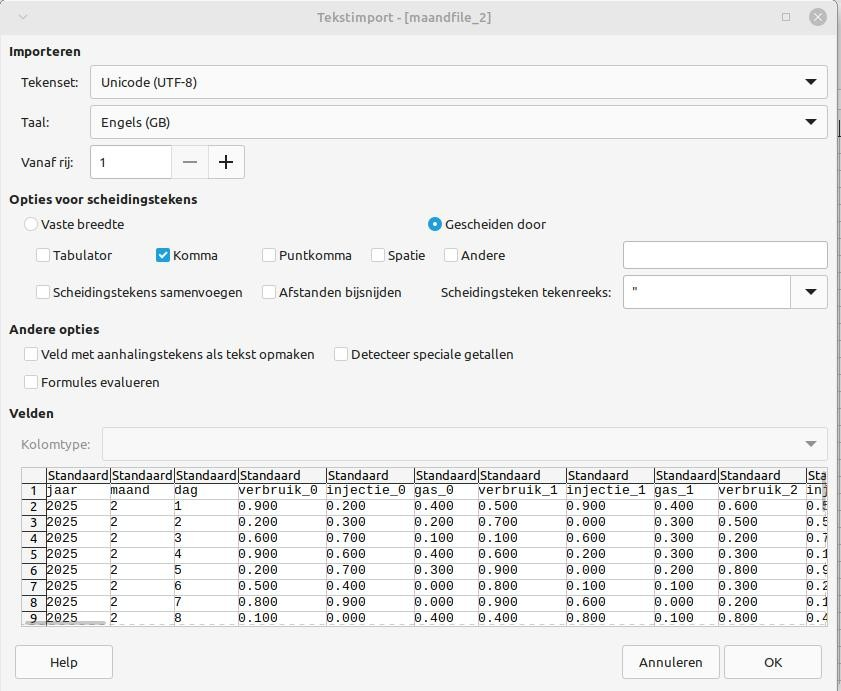
[picture p33: figure]

Data opslag SD kaart

1 folder per jaar /2025

in deze folder
12 maand files
/2025/maandfile_1
/2025/…
/2025/maandfile_12

in deze file 1 rij per dag

## opbouw

zoals hierboven beschreven

1 maanddata file
/2025/maanddata
wordt door het programma gebruikt om de maandtotalen vlugger terug te vinden in deze file 1 rij per maand

## opbouw

header
maand,verbruik_maand,injectie_maand,gas_maand,maandpiek

kolom | data | formaat
A | maand | int
B | maand verbruik | float 3 decimalen
C | maand injectie | float 3 decimalen
D | maand gas verbruik float 3 decimalen
E | maandpiek | float 3 decimalen

1 folder /jaar_data
wordt door het programma gebruikt om de jaartotalen vlugger terug te vinden in deze folder 1 file
/jaar_data/jaardata
in deze file 1 rij per jaar

## opbouw

header
jaar,verbruik_jaar,injectie_jaar,gas_jaar
kolom | data | formaat
A | jaar | int
B | jaar verbruik | float 3 decimalen
C | jaar injectie | float 3 decimalen
D | jaar verbruik | float 3 decimalen

Dat was het,
Live long and prosper [Vulcaans: Dif-tor heh smusma] (bron : Wikipedia),

thieu-b55
december 2025
