thieu-b55/Slimme-meter-ESP32-V2/(threads)

Thread 1 (2024-11-14):

flashen firmware / foutmeldingen/waarschuwingen compiler

i32x, 2024-11-14:

i32x, 2024-11-14:
wat moeilijkheden met invullen,
met vriendelijke groet,

thieu-b55, 2024-11-14:
Nieuwe .bin files geupload, probleem zou opgelost moeten zijn.
Sorry voor het ongemak.

Foutmelding lijn 377.
Warning voor het ontbreken van

uint32_t idle_core_mask

voor meer uitleg zie
https://docs.espressif.com/projects/esp-idf/en/stable/esp32/api-reference/system/wdts.html#structures

Closed 2024-11-16.

Thread 2 (2024-11-24):

schematic

Eggberry, 2024-11-24:
Is there some where a electric connection diagram for this meter read unit ?

thieu-b55, 2024-11-30:
Slimme Meter ESP32 V2.pdf page 9

Closed 2024-12-01.

Thread 3 (2024-12-09):

Connectie ESP32 - P1

wannestal, 2024-12-09:
Hallo,

1. hoe is de esp32 verbonden met de P1 poort?
2. wordt de esp32 gevoed met de spanning uit de P1 poort? Ik vraag me af of deze genoeg stroom kan leveren.

mvg
Wannes

thieu-b55, 2024-12-13:
Zie pagina 9 van bijgevoegde pdf file "Slimme meter ESP32 V2.pdf"

vriendelijke groeten,
thieu-b55

Closed 2024-12-13.

Thread 4 (2024-12-11):

PWM output

brandklijnstra, 2024-12-11:
Misschien heb ik het mis, of levert het geen probleem op. Als de PWM een puls uit stuurt, dan zal die niet in fase zijn met met de netspanning. In andere systemen wordt dit meestal opgelost dmv een trafo en een diode die na een ingang gaat. De opgaande flank van die ingang is dan begin van de PWM puls.

thieu-b55, 2024-12-13:
Het PWM signaal gaat naar een Solid State relais, pagina 32 van "Slimme meter ESP32 V2.pdf", hierin zou dit aanwezig moeten zijn, Voor mij werkt het in elk geval prima. Je kan dit zelf ook eens proberen door het verwarmingselement te vervangen door een goede ouderwetse gloeilamp en deze aan te sluiten op een solid state relais. De lichtsterkte van de lamp reageert mooi met het verhogen of verlagen van de duty cycle van het PWM signaal.

vriendelijke groeten,
thiue-b55

brandklijnstra, 2024-12-17:
Thieu,
dank voor je antwoord. Begin volgend jaar ga ik het een en ander proberen.
Aan de programma's heb ik de .h files toegevoegd. Waren prima te vinden.
Compileren leverde geen problemen op. Was eerst van plan om een ESP8266 te
gebruiken uit eigen voorraad, maar die heeft toch wat beperkingen. Ben ook
benieuwd hoe het gaat met de PWM. Wat ik bedoelde met het aansnijden van de
sinus door PWM, dit staat ook in de link beschreven hieronder. Ik heb zelf
een opleiding in de energietechniek gehad en hier in de praktijk ook mee te
maken gehad. Dit is natuurlijk geen kritiek op het ontwerp. Groet Brand

Zonne-energierouter om overproductie te beheren (doe-het-zelf) - F1ATB
<https://f1atb.fr/diy-solar-energy-router-to-manage-overproduction/>

Op vr 13 dec 2024 om 10:03 schreef thieu-b55 ***@***.***>:

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

Closed 2024-12-13.

Thread 5 (2025-01-20):

Schrijven naar SD kaart

noboots, 2025-01-20:
Ik heb ondertussen een ESP32 en een SD kaart met houder in elkaar zitten.
Alles lijkt goed te gaan alleen komt er niets op de SD kaart staan.

Wat is er getest
- Als er geen SD kaart in zit tijdens reboot, gaat de error led aan en wordt het via de serial out gemeld dat die niet werkt.
- Als er een SD kaart in zit geen error's te zien maar ik kan geen data terug vinden op de kaart.   Niet in de web pagina, niet op de kaart als ik ze in mijn PC stop.
- Een ander esp32 programma op het zelfde hardware (esp / SD kaart / SD kaart houder) kan wel op de SD kaart schrijven en als ik die nadien in mijn pc stop zie je er wel files op staan...  (https://randomnerdtutorials.com/esp32-microsd-card-arduino/)

thieu-b55, 2025-01-24:
Is de module al verbonden met de slimme meter. Schrijven naar SD kaart gebeurt pas na inlezen van een boodschap van de meter.
Een andere mogelijke reden voor het niet schrijven kan ik momenteel helaas niet bedenken.

groeten,
thieu

Closed 2025-01-27.

Thread 6 (2025-02-03):

Slimme meter in de praktijk

brandklijnstra, 2025-02-03:
Thieu,
rond 1 januari heb de arduino bij de smartmeter geplaatst. De voeding heb ik ook uit poort 1 betrokken. De meter is een Landis & Gyr E360. Een 3 fasenmeter die veelvuldig in NL door Liander wordt geplaatst. Er hoeft bij ons geen aanvraag worden gedaan om de poort actief te maken. Voor deze meter heb ik 1 wijziging doorgevoerd ten behoeve van de gasmeter. Op regel 1000 heb ik 24.2.1 vervangen door 24.2.3 Het enigste probleem wat er nu nog is dat bij een aansturing van 100% op PWM 1 deze waarde bevroren blijft. Hij regelt dus niet meer terug zodra er geen injectie meer is, of minder injectie. Dit is alleen maar op te lossen door een reset te geven. Dit is mijn instelling: 2.00kW 8.00hr  17.00hr A

Aan de PWM zijde heb ik meer wijzigingen doorgevoerd. Het idee van de PWM rechtstreeks naar de Triac toe te sturen heb ik verlaten. Ik had de beschikking over een dimmer met zerocross detectie. Als de nuldoorgang wordt gezien, en dat is twee maal per sinus, begint er een tijd te lopen. Na een bepaalde tijd, en die is dus afhankelijk van het percentage, wordt de Triac aangestuurd. Bij de volgende zerocross dooft hij weer. De triac schakelt dus maar 100 keer per seconde. Ik denk er nog over om relais contact te plaatsen parallel aan de Triac. Dit relais werkt alleen als de aansturing  100% is. Daarmee is een dissipatie over de Triac te besparen van tussen de 5 en 10 Watt. Zodra de klus af is stuur ik de software.

thieu-b55, 2025-02-03:
Hallo Brandklijnstra,
if(lees_byte == 0x0a){
      if((buffer_data.substring(4,9)) == "1.0.0"){
        jaar_int = ((buffer_data.substring(10,12)).toInt()) + 2000;
        maand_int = (buffer_data.substring(12,14)).toInt();;
        dag_int = (buffer_data.substring(14,16)).toInt();
        uren_int = (buffer_data.substring(16,18)).toInt();;
        minuten_int = (buffer_data.substring(18,20)).toInt();;
      }
      if((buffer_data.substring(4,9)) == "1.8.1"){
        kwh_dag = buffer_data.substring(10,20);
      }
      if((buffer_data.substring(4,9)) == "1.8.2"){
        kwh_nacht = buffer_data.substring(10,20);
      }
      if((buffer_data.substring(4,9)) == "2.8.1"){
        injectie_dag = buffer_data.substring(10,20);
      }
      if((buffer_data.substring(4,9)) == "2.8.2"){
        injectie_nacht = buffer_data.substring(10,20);
      }
      if((buffer_data.substring(4,9)) == "1.7.0"){
        kwh_nu = buffer_data.substring(10,16);
      }
      if((buffer_data.substring(4,9)) == "2.7.0"){
        injectie_nu = buffer_data.substring(10,16);
      }
      if((buffer_data.substring(4,9)) == "1.6.0"){
        piek_nu = buffer_data.substring(25,31);
      }nig
      if((buffer_data.substring(4,10)) == "24.2.3"){
        gas = buffer_data.substring(26,35);
      }

in het programma  Slimme_meter_esp32_V2.ino hier op Github staat op regel 998  24.2.3 voor gas.
24.2.1 zie ik nergens staan. Download het programma eens opnieuw en programmeer het dan nog eens in je ESP32.
Hopelijk helpt dat.
In verband met de PWM sturing, ik heb bij Mijnheer Ali een solid state relais gekocht, zie pagina 31 van de pdf file. Kost weinig en werkt perfekt.

vriendelijke groeten,
thieu.

thieu-b55, 2025-02-04:
*

thieu-b55, 2025-02-05:
Hoi brandklijnstra,

ik had het stukje over de tijdinstelling van de PWM1 sturing niet goed gelezen.
Het werkt als volgt
KW : vul hier het vermogen in van je boiler.
1:      vul hier in vanaf wanneer er 100% moet gestuurd worden, dus onafhankelijk van het opgewekte vermogen.
0:      vul hier in wanneer het 100% sturen gestart met "1" terug naar automatisch moet overschakelen, dus afhankelijk van het       opgewekte vermogen.
de instelling A/M heeft geen invloed op deze instellingen.
Indien je geen gebruik wil maken van de "0" / "1" instelling vul dan het volgende in
1: 24:00
0: 00:00

Indien je bijvoorbeeld altijd 's avonds wil bijwarmen van 20u tot 22u
1: 20:00
0: 22:00

sorry als het in de handleiding misschien niet zo duidelijk was uitgelegd

gr,
thieu

brandklijnstra, 2025-02-05:
Thieu,
bedankt. Ik kan eerst weer verder. Groet Brand

Op wo 5 feb 2025 om 08:29 schreef thieu-b55 ***@***.***>:

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

Closed 2025-02-04.

Thread 7 (2025-04-03):

Esp32 wroom blijft zichzelf herstarten

Srallie, 2025-04-03:
De esp blijft zich na een succesvolle firmware update met arduino ide herstarten. Ik kan even de webpagina bezoeken maar de verbinding verbreekt steeds,wifi led gaat uit op de esp en herstart zich.

thieu-b55, 2025-04-04:
Hoi Srallie,

Heb je de condensators parallel over de 5V geplaatst?
Kort na elkaar de webpagina proberen te updaten kan ook een probleem zijn.
Het vermogen van de 5V van de digitale meter is niet genoeg om de ESP32 te voeden, dit wordt opgevangen door condensators.
Probeer eventueel eens een externe 5V voeding.
Als dit niet het probleem is, heb ik helaas geen ander idee.

vriendelijke groeten,
thieu

Srallie, 2025-04-04:
Hoi,

Ik heb hem alleen ingestoken in de laptop usb poort en kijk mee met de seriële monitor van arduino,hier zie ik dat hij steeds opnieuw opstart. Ik heb hem nog niet fysiek gekoppeld aan de p1 poort. Kan dat hiermee te maken hebben dat hij nog geen inkomens signaal krijgt?

Gr Lars

Verzonden vanaf Outlook voor Android<https://aka.ms/AAb9ysg>
________________________________
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

thieu-b55, 2025-04-04:
Zonder inkomend signaal krijg je geen resultaten op de webpagina of sd kaart.
Ik veronderstel dat je USB poort niet genoeg vermogen kan leveren.
Om zeker te zijn, gewoon inpluggen in de P1 poort.

vriendelijke groeten,
thieu

thieu-b55, 2025-04-05:
*

Closed 2025-04-05.

Thread 9 (2025-09-04):

Combine to ESP32- CYD ?

Jempiken, 2025-09-04:
Hallo, Thieu
knap project
Gezien nu de supergoedkope CYD op de markt zijn, mss es een ideetje om alles daarop te draaien ?
Al geprobeerd ?
JP

thieu-b55, 2025-09-04:
Hoi JP,

bedankt voor de interesse in dit project.
De ESP32-CYD heb ik nog niet geprobeerd, maar een leuk idee voor een volgend project.

vriendelijke groeten,
thieu

thieu-b55, 2025-09-22:
Hoi JP,

sorry voor het late antwoord.
Bedankt voor de interesse in dit project(je). Ik heb die gele displays nog
niet geprobeerd, maar zijn het proberen waard.
bedankt voor de tip.

vriendelijke groeten,
thieu

Op do 4 sep 2025 om 09:28 schreef Jemp ***@***.***>:

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

Jempiken, 2025-09-22:
Top

Als je iets doet, hoor ik het graag

Dank

JP

Van: thieu-b55 ***@***.***>
Verzonden: maandag 22 september 2025 8:11
Aan: thieu-b55/Slimme-meter-ESP32-V2 ***@***.***>
CC: Jemp ***@***.***>; Author ***@***.***>
Onderwerp: Re: [thieu-b55/Slimme-meter-ESP32-V2] Combine to ESP32- CYD ? (Issue #9)

  <https://avatars.githubusercontent.com/u/99279324?s=20&v=4> thieu-b55 left a comment (thieu-b55/Slimme-meter-ESP32-V2#9) <https://github.com/thieu-b55/Slimme-meter-ESP32-V2/issues/9#issuecomment-3317085611>

Hoi JP,

sorry voor het late antwoord.
Bedankt voor de interesse in dit project(je). Ik heb die gele displays nog
niet geprobeerd, maar zijn het proberen waard.
bedankt voor de tip.

vriendelijke groeten,
thieu

Op do 4 sep 2025 om 09:28 schreef Jemp ***@***.*** <mailto:***@***.***> >:

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

—
Reply to this email directly, view it on GitHub <https://github.com/thieu-b55/Slimme-meter-ESP32-V2/issues/9#issuecomment-3317085611> , or unsubscribe <https://github.com/notifications/unsubscribe-auth/ANHOSVVNC3WQUGQG32HJZP33T6HFRAVCNFSM6AAAAACFS7JKDSVHI2DSMVQWIX3LMV43OSLTON2WKQ3PNVWWK3TUHMZTGMJXGA4DKNRRGE> .
You are receiving this because you authored the thread.  <https://github.com/notifications/beacon/ANHOSVUEVFI6EOWMEHSVEFL3T6HFRA5CNFSM6AAAAACFS7JKDSWGG33NNVSW45C7OR4XAZNMJFZXG5LFINXW23LFNZ2KUY3PNVWWK3TUL5UWJTWFW222W.gif> Message ID: ***@***.*** ***@***.***> >
